pdiefend/Lux/Light Sphere BOM.xlsx

PCB no | part | Vendor | part No | cost / unit | quantity/prototype | quantity to order | sub total | Desc / Location / Comments
Adafruit Components
N/A | WS2812 LEDs (10 pk) | Adafruit | 1379 (https://www.adafruit.com/products/1379) | $4.50 | 8 | 8 | $36.00
 |  |  |  |  |  | taxes & shipping | $4.07 | Arrived
 |  |  |  |  |  | Adafruit sub | $40.07
Sparkfun Components
JP6 | JST-PH 2 pin | Sparkfun | PRT-08612 (https://www.sparkfun.com/products/8612) | $0.95 | 1 | 2 | $1.90 | Power Supply
BATT | 1000 mAh Lipo | Sparkfun | PRT-00339 (https://www.sparkfun.com/products/339) | $8.95 | 1 | 1 | $8.95
 |  |  |  |  |  | taxes & shipping | $4.01 | Arrived
 |  |  |  |  |  | Sparkfun sub | $14.86
Mouser Components
U1 | ATMega 328p | Mouser | 556-ATMEGA328P-AU (http://www.mouser.com/ProductDetail/Atmel/ATMEGA328P-AU/) | $3.12 | 1 | 2 | $6.24 | Main uC
U2 | Accelerometer | Mouser | 841-MMA8452QR1 (http://www.mouser.com/ProductDetail/Freescale-Semiconductor/MMA8452QR1/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) | $1.31 | 1 | 2 | $2.62 | 3-axis accelerometer
R1,R2 | 4.7 k-ohm 0603 | Mouser | 71-CRCW0603-4.7K-E3 (http://www.mouser.com/ProductDetail/Vishay-Dale/CRCW06034K70FKEA/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) | $0.08 | 2 | 4 | $0.32 | Accel
C2,C3,C6 | 0.1uF 0603 | Mouser | 77-VJ0603Y104KXJCBC (http://www.mouser.com/ProductDetail/Vishay-Vitramon/VJ0603Y104KXJCW1BC/) | $0.06 | 3 | 6 | $0.36 | Accel,FTDI
C1 | 4.7uF 0603 | Mouser | 81-GRM18R60J475KE19D (http://www.mouser.com/ProductDetail/Murata-Electronics/GRM188R60J475KE19D/) | $0.08 | 1 | 2 | $0.16 | Accel
C7,8 | 10uF 0603 | Mouser | 810-C1608X5R0J106M (http://www.mouser.com/ProductDetail/TDK/C1608X5R0J106M080AB/) | $0.31 | 2 | 4 | $1.24 | Power Supply
R3,6, 7, 9, 11,12 | 10k-ohm 0603 | Mouser | 71-CRCW0603-10K-E3 (http://www.mouser.com/ProductDetail/Vishay-Dale/CRCW060310K0FKEA/) | $0.01 | 5 | 10 | $0.13 | Mode/Reset
RESET,MODE | Pushbutton | Mouser | 611-PTS525SM10-LFS (http://www.mouser.com/ProductDetail/CK-Components/PTS525SM10SMTR-LFS/) | $0.63 | 2 | 4 | $2.52 | Mode/Reset
R5 | 220 resistor | Mouser | 71-CRCW0603-220-E3 (http://www.mouser.com/ProductDetail/Vishay-Dale/CRCW0603220RFKEA/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) | $0.08 | 1 | 2 | $0.16 | Status LED
LED1,L2 | Red LED | Mouser | 78-VLMS1300-GS08 (http://www.mouser.com/ProductDetail/Vishay-Semiconductors/VLMS1300-GS08/) | $0.08 | 2 | 4 | $0.32 | Status LED
C4,C5 | 18pF | Mouser | 77-VJ0603A180JXJPBC (http://www.mouser.com/ProductDetail/Vishay-Vitramon/VJ0603A180JXJPW1BC/) | $0.08 | 2 | 4 | $0.32 | Clock
R4 | 1M-ohm 0201 | Mouser | 71-CRCW02011M00FNED (http://www.mouser.com/ProductDetail/Vishay-Dale/CRCW02011M00FNED/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) | $0.10 | 1 | 2 | $0.20 | Clock
Y1 | 16 MHz crystal | Mouser | 815-ABM3C-16-D4YT (http://www.mouser.com/ProductDetail/ABRACON/ABM3C-16000MHZ-D4Y-T/) | $0.90 | 1 | 2 | $1.80 | Clock
R13,14,8 | 1k-ohm 0603 | Mouser | 71-CRCW0603-1.0K-E3 (http://www.mouser.com/ProductDetail/Vishay-Dale/CRCW06031K00FKEA/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) | $0.08 | 3 | 6 | $0.48 | Light, Power Supply
U4 | MCP73831 | Mouser | 579-MCP73831T-2DCIOT (http://www.mouser.com/ProductDetail/Microchip-Technology/MCP73831T-2DCI-OT/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) | $0.60 | 1 | 2 | $1.20 | Power Supply
R10 | 2k resistor | Mouser | 71-CRCW0603-2.0K-E3 (http://www.mouser.com/ProductDetail/Vishay-Dale/CRCW06032K00FKEA/) | $0.08 | 1 | 2 | $0.16 | Power Supply
L1 | Green LED | Mouser | 78-VLMTG1300-GS08 (http://www.mouser.com/ProductDetail/Vishay-Semiconductors/VLMTG1300-GS08/) | $0.14 | 1 | 2 | $0.28 | Status LEDs
U3 | 3.3 Regulator | Mouser | 998-MIC5205-3.3YM5TR (http://www.mouser.com/ProductDetail/Micrel/MIC5205-33YM5-TR/) | $0.97 | 1 | 2 | $1.94
U5 | FTDI 232 interface | Mouser | 895-FT232RL (http://www.mouser.com/ProductDetail/FTDI/FT232RL-REEL/?qs=sGAEpiMZZMs5ceO8zL%252bTxyQLQIH6hE7q) | $4.50 | 1 | 2 | $9.00
Q1,2,3 | BSS138 SOT23 | Mouser | 512-BSS138 (http://www.mouser.com/ProductDetail/Fairchild-Semiconductor/BSS138/) | $0.22 | 3 | 6 | $1.32
USB | USB micro port | Mouser | 571-1734035-1 (http://www.mouser.com/ProductDetail/TE-Connectivity/1734035-1/) | $1.13 | 1 | 2 | $2.26
 |  |  |  |  |  | taxes & shipping | $4.99 | Arrived
 |  |  |  |  |  | Mouser sub | $38.02
Other Parts
ICSP | Header-ICSP | - | 2x3 | $0.00 | 1 | 2 | $0.00
OSH park
PCB | circuit board | OSH Park | - | $20.00 | 1 | 1 | $20.00 | $5/in^2 for 3 boards (board is 4 in^2, getting 3)
 |  |  |  |  |  | taxes & shipping | $0.00 | Arrived
 |  |  |  |  |  | OSH park sub | $20.00
Pololu
- | Boost Converter | Pololu | http://www.pololu.com/product/2565 | $13.95 | 1 | 1 | $13.95
 |  |  |  |  |  | taxes & shipping | $3.95 | Arrived
 |  |  |  |  |  | Pololu sub | $17.90
 | Prototypes | 2 | (One to mess up and one to make for PCB and SMD parts) |  |  | Project Total | $130.85
 |  |  |  |  |  | Prototype Total | $65.42
Still need: | Qty
4-40 1/2" standoff | 4
4-40 1/4" standoff | 4
