pdiefend/Lux/acad/toSolidworks.dxf

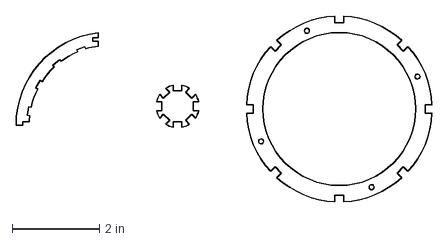
[picture p8: CAD file, 2016-04-09]
acad/toSolidworks.dxf
9.52 x 4.25 in
