pdiefend/Lux/acad/brd.dxf

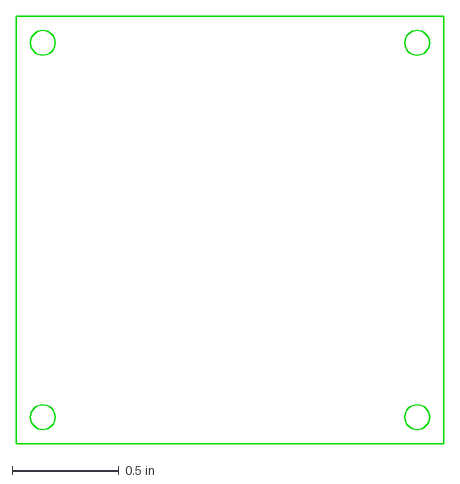
[picture p9: CAD file, 2016-04-09]
acad/brd.dxf
2.00 x 2.00 in
