pdiefend/Lux/acad/spacingTest.dxf

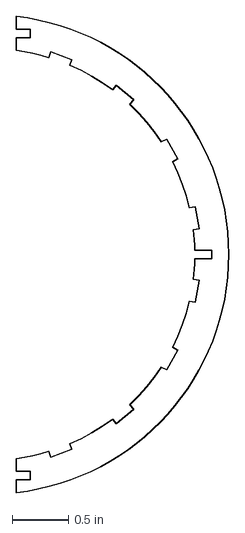
[picture p10: CAD file, 2016-04-09]
acad/spacingTest.dxf
1.88 x 4.22 in
