pdiefend/Lux/sldwrks/cut2.DXF

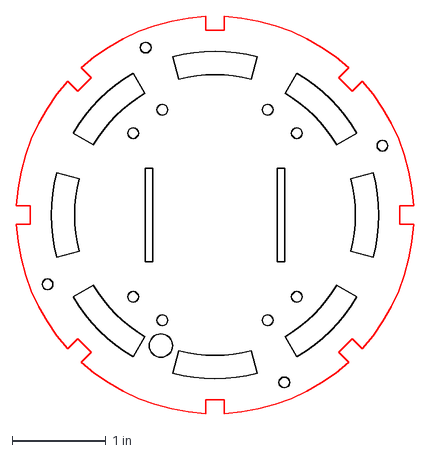
[picture p11: CAD file, 2016-04-09]
sldwrks/cut2.DXF
4.25 x 4.25 in
