pdiefend/Lux/sldwrks/cut1.dxf

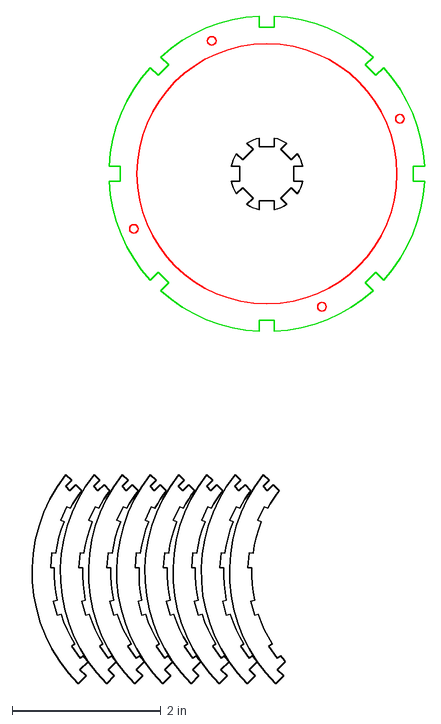
[picture p12: CAD file, 2016-04-09]
sldwrks/cut1.dxf
5.49 x 8.99 in
