pdiefend/Lux/(list of files, cad)

Other CAD files:
acad/Lux.dwg
acad/toSolidworks.dwg
sldwrks/boardRing2.DXF
