pdiefend/Lux/schematic.pdf

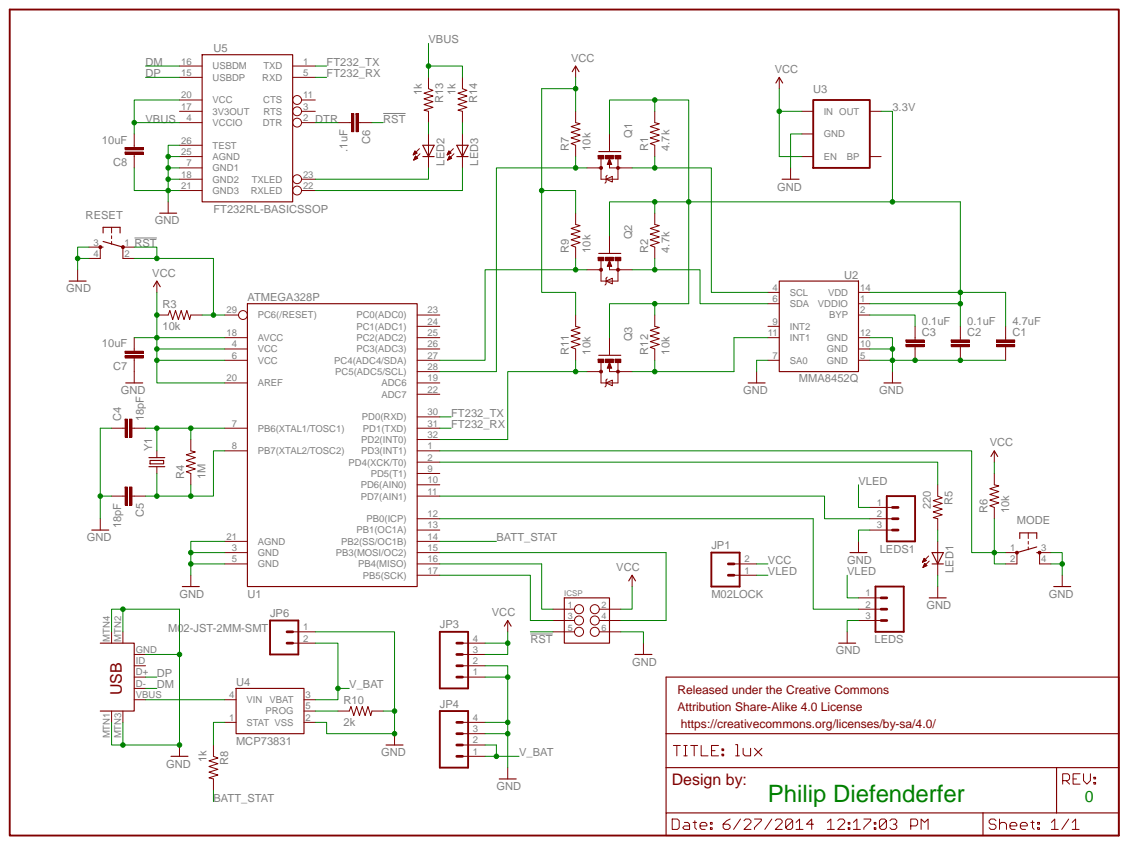
[picture p13: page 1]

USB Released under the Creative Commons

Attribution Share-Alike 4.0 License
https://creativecommons.org/licenses/by-sa/4.0/

Design by: Philip Diefenderfer
