pdiefend/Lux/luxSphere/lux.brd

## EAGLE design luxSphere/lux.brd (2016-04-09)

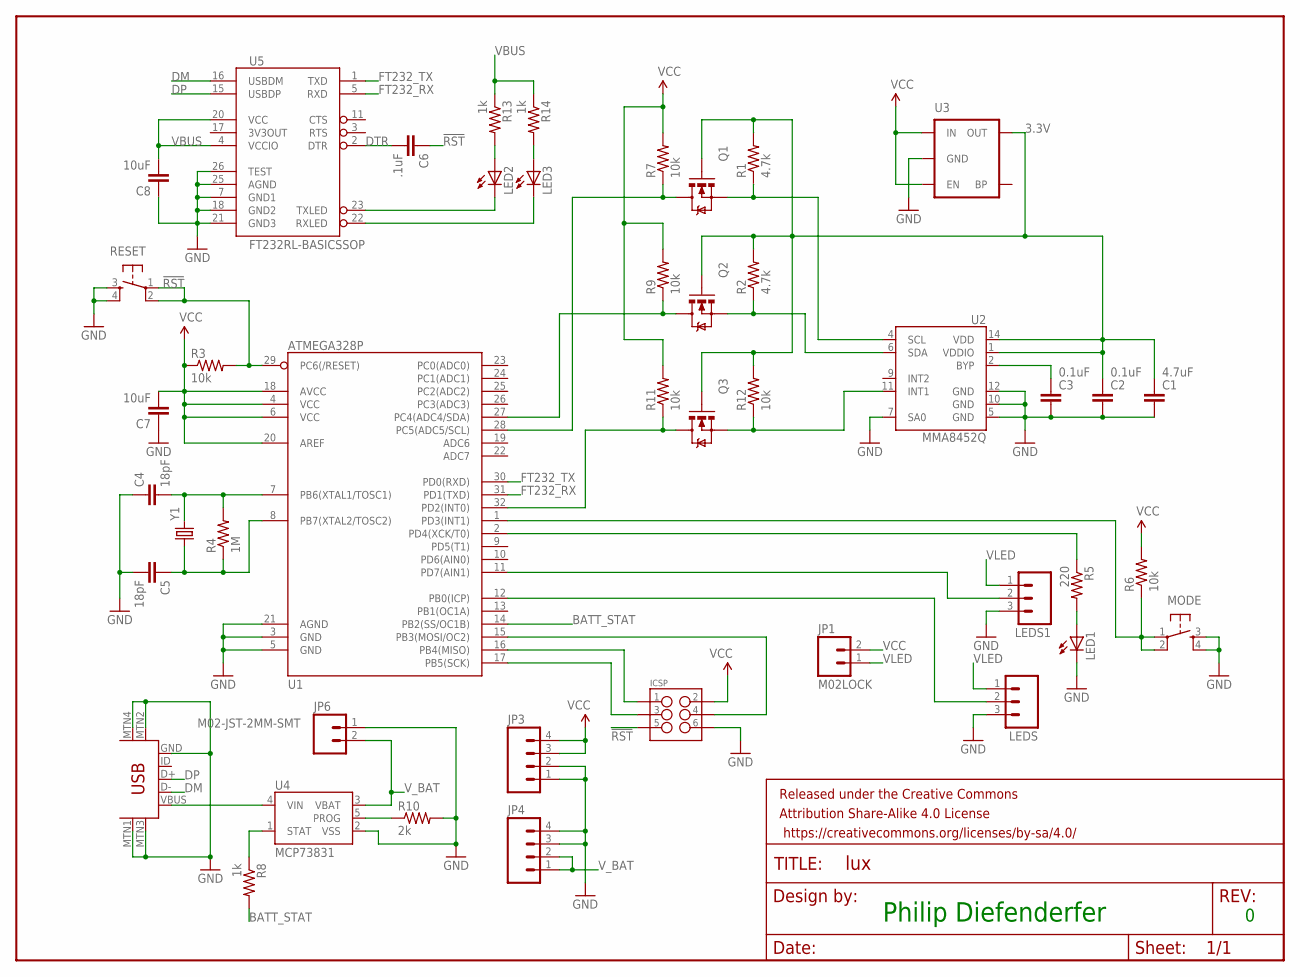
[picture p14: schematic lux.sch]

Parts:
C1: 4.7uF; 0603-CAP
C2, C3: 0.1uF; 0603-CAP
C4, C5: 18pF; 0603-CAP
C6: .1uF; 0603-CAP
C7, C8: 10uF; 0603-CAP
FRAME1: FRAME-LETTER; CREATIVE_COMMONS
ICSP: M03X2POGO_PINS; 2X3_POGO
JP1: M02LOCK; 1X02_LOCK
JP3, JP4: M04LOCK; 1X04_LOCK
JP6: M02-JST-2MM-SMT; JST-2-SMD
JP7: USB-MINIB-5PIN; USB-MINIB
LED1, LED2, LED3: LED0603; LED-0603
LEDS, LEDS1: M03PTH; 1X03
MODE: TAC_SWITCHSMD; TACTILE_SWITCH_SMD
Q1, Q2, Q3: MOSFET-NCHANNELBSS138; SOT23
R1, R2: 4.7k; 0603-RES
R3, R6, R7, R9, R11, R12: 10k; 0603-RES
R4: 1M; 0603-RES
R5: 220; 0603-RES
R8, R13, R14: 1k; 0603-RES
R10: 2k; 0603-RES
RESET: TAC_SWITCHSMD; TACTILE_SWITCH_SMD
U1: ATMEGA328P; TQFP32-08
U2: MMA8452Q; QFN-16_0.5MM
U3: MIC52053.3V; SOT23-5
U4: MCP73831; SOT23-5
U5: FT232RL-BASICSSOP; SSOP28DB
Y1: CRYSTAL5X3; CRYSTAL-SMD-5X3

Connections:
3.3V: C1.1, C2.1, Q1.1 (G), Q2.1 (G), Q3.1 (G), R1.2, R2.2, R12.2, U2.1 (VDDIO), U2.14 (VDD), U3.5 (OUT)
!RST: C6.1, ICSP.P$5 (5), R3.2, RESET.1, RESET.2, U1.29 (PC6(/RESET))
BATT_STAT: R8.2, U1.14 (PB2(SS/OC1B))
DM: JP7.D-, U5.16 (USBDM)
DP: JP7.D+, U5.15 (USBDP)
DTR: C6.2, U5.2 (DTR)
FT232_RX: U1.31 (PD1(TXD)), U5.5 (RXD)
FT232_TX: U1.30 (PD0(RXD)), U5.1 (TXD)
GND: C1.2, C2.2, C3.2, C4.1, C5.2, C7.1, C8.1, ICSP.P$6 (6), JP3.1, JP3.2, JP4.3, JP4.4, JP6.1 (2), JP7.GND, JP7.MTN1 (MTN2), JP7.MTN2 (MTN3), JP7.MTN3 (MTN1), JP7.MTN4, LED1.C, LEDS.3, LEDS1.3, MODE.3, MODE.4, R10.2, RESET.3, RESET.4, U1.3 (GND), U1.5 (GND), U1.21 (AGND), U2.5 (GND), U2.7 (SA0), U2.10 (GND), U2.12 (GND), U3.2 (GND), U4.2 (VSS), U5.7 (GND1), U5.18 (GND2), U5.21 (GND3), U5.25 (AGND), U5.26 (TEST)
N: R8.1, U4.1 (STAT)
unnamed: R10.1, U4.5 (PROG)
unnamed: LED2.C, U5.23 (TXLED)
unnamed: C3.1, U2.2 (BYP)
unnamed: ICSP.P$1 (1), U1.16 (PB4(MISO))
unnamed: LED1.A, R5.2
unnamed: ICSP.P$3 (3), U1.17 (PB5(SCK))
unnamed: MODE.1, MODE.2, R6.1, U1.1 (PD3(INT1))
unnamed: ICSP.P$4 (4), U1.15 (PB3(MOSI/OC2))
unnamed: C4.2, R4.2, U1.7 (PB6(XTAL1/TOSC1)), Y1.3 (2)
unnamed: C5.1, R4.1, U1.8 (PB7(XTAL2/TOSC2)), Y1.1
unnamed: R5.1, U1.2 (PD4(XCK/T0))
unnamed: LED3.C, U5.22 (RXLED)
unnamed: LED2.A, R13.2
unnamed: Q3.2 (S), R12.1, U2.11 (INT1)
unnamed: LED3.A, R14.2
unnamed: Q1.2 (S), R1.1, U2.4 (SCL)
unnamed: Q1.3 (D), R7.1, U1.28 (PC5(ADC5/SCL))
unnamed: Q2.2 (S), R2.1, U2.6 (SDA)
unnamed: Q2.3 (D), R9.1, U1.27 (PC4(ADC4/SDA))
unnamed: Q3.3 (D), R11.1, U1.32 (PD2(INT0))
P7: LEDS1.2, U1.11 (PD7(AIN1))
P8: LEDS.2, U1.12 (PB0(ICP))
VBUS: C8.2, JP7.VBUS, R13.1, R14.1, U4.4 (VIN), U5.4 (VCCIO), U5.20 (VCC)
VCC: C7.2, ICSP.P$2 (2), JP1.2, JP3.3, JP3.4, R3.1, R6.2, R7.2, R9.2, R11.2, U1.4 (VCC), U1.6 (VCC), U1.18 (AVCC), U1.20 (AREF), U3.1 (IN), U3.3 (EN)
VLED: JP1.1, LEDS.1, LEDS1.1
V_BAT: JP4.1, JP4.2, JP6.2 (1), U4.3 (VBAT)

Notes on the sheet:
Philip Diefenderfer

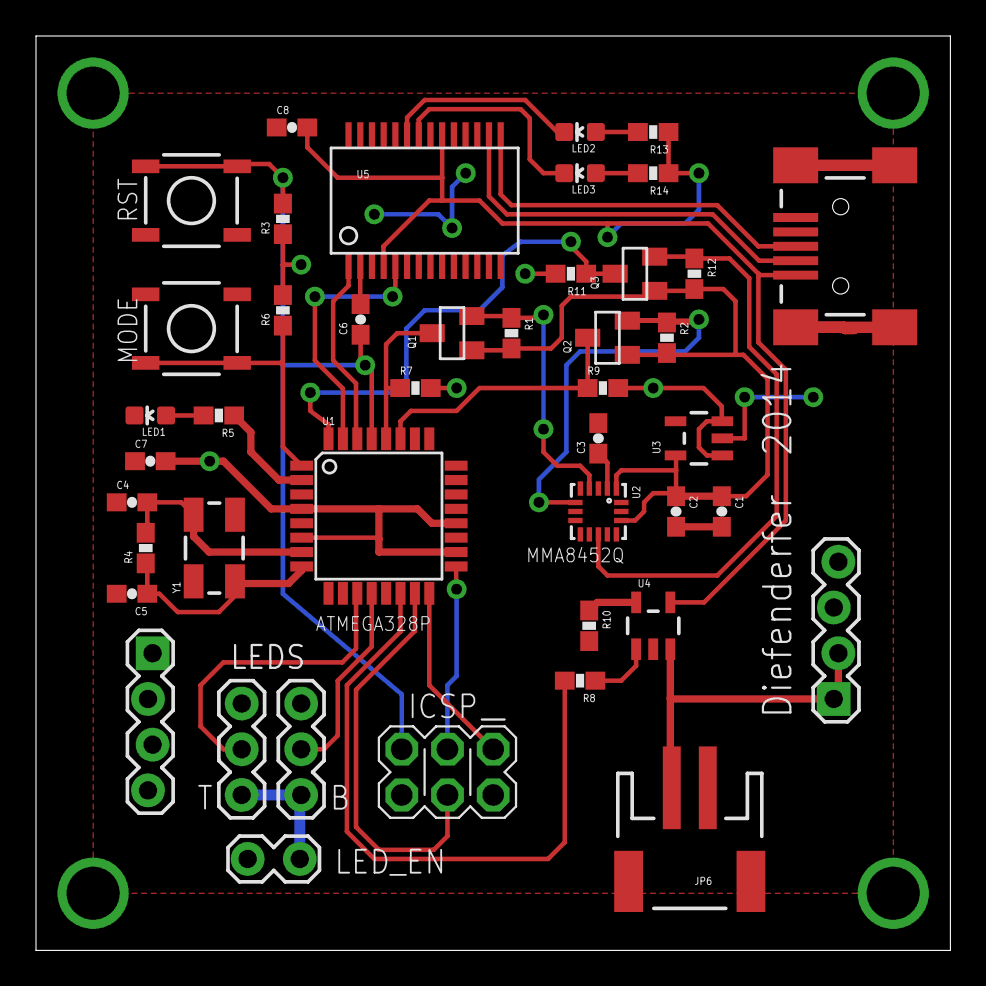
[picture p15: board lux.brd from above]

Board: 2 copper layers, 50.8 x 50.8 mm, 45 parts (0 on the bottom side), 36 nets.
