pdiefend/Lux/(commit log)

2016-04-09 Pushing existing hardware design files to github. These will not change unless I build a new version of Lux (which I may or may not be working on)
    [FTDI Basic-v21-5V.brd, FTDI Basic-v21-5V.sch, Light Sphere BOM.xlsx, Lux.dwg, asm2.SLDASM, baseRing.SLDPRT, batteryBank.SLDPRT, batteryWall.SLDPRT]
2016-04-10 Broke lux.ino into different files in preparation of merging all the various modes scattered across the sketches into one main file. Also added a Game of Life sketch in preparation of a new mode.
    [Life.ino, MMA8452Q.cpp, MMA8452Q.h, lux.ino]
